SET-22/ftc-robot-code/animatronic-face/cad/exports/animatronic_face_assembly.step

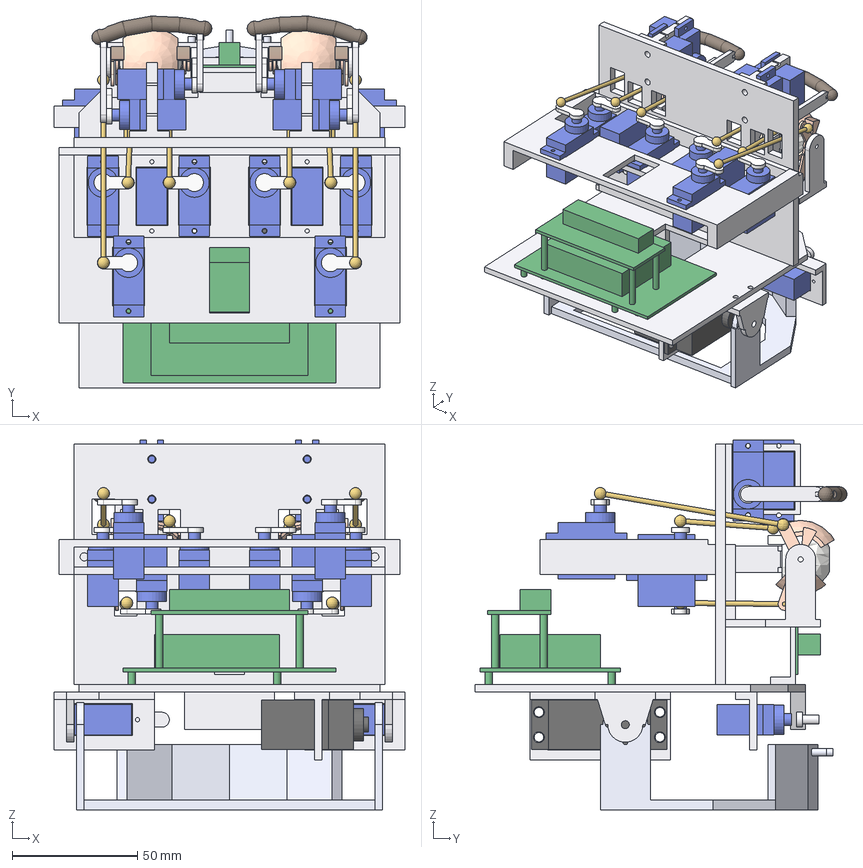
[picture p4: CAD file, 2026-11-02]
animatronic-face/cad/exports/animatronic_face_assembly.step
140.0 x 148.5 x 147.6 mm
eyeball_R
eye_cross_R
eye_frame_R
eyelid_upper_R
eyelid_lower_R
eyeball_L
eye_cross_L
eye_frame_L
eyelid_upper_L
eyelid_lower_L
face_plate
base_plate
eye_servo_cradle
servo_eyeA_R
servo_eyeA_R_horn
rod_eyeA_R
servo_eyeB_R
servo_eyeB_R_horn
rod_eyeB_R
servo_lidU_R
servo_lidU_R_horn
rod_lidU_R
servo_lidL_R
servo_lidL_R_horn
rod_lidL_R
servo_eyeA_L
servo_eyeA_L_horn
rod_eyeA_L
servo_eyeB_L
servo_eyeB_L_horn
rod_eyeB_L
servo_lidU_L
servo_lidU_L_horn
rod_lidU_L
servo_lidL_L
servo_lidL_L_horn
rod_lidL_L
servo_browIn_R
servo_browIn_R_horn
brow_lever_in_R
servo_browOut_R
servo_browOut_R_horn
brow_lever_out_R
servo_browIn_L
servo_browIn_L_horn
brow_lever_in_L
servo_browOut_L
servo_browOut_L_horn
brow_lever_out_L
brow_bracket_R
brow_strip_R
brow_bracket_L
brow_strip_L
servo_jaw
jaw
jaw_servo_bracket
jaw_hinge_bracket_R
jaw_hinge_bracket_L
servo_corner_R
mouth_corner_lever_R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
