SET-22/ftc-robot-code/animatronic-face/cad/exports/step/face_plate.step

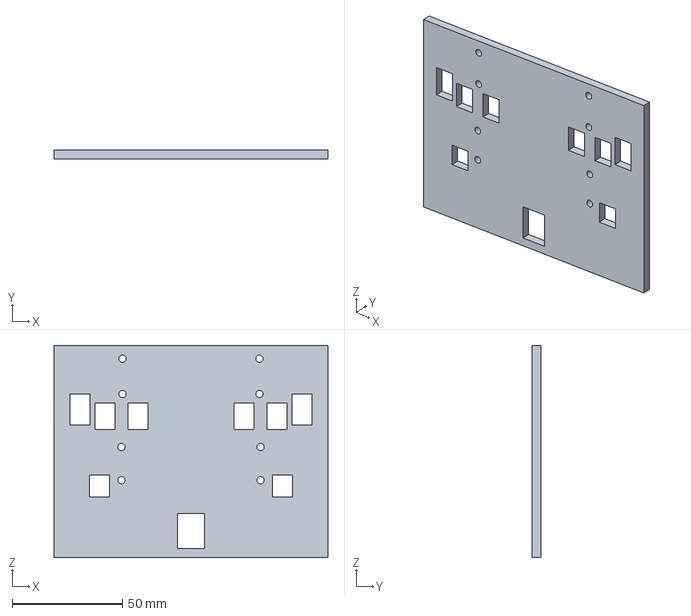
[picture p5: CAD file, 2026-11-02]
animatronic-face/cad/exports/step/face_plate.step
124.0 x 4.00 x 96.0 mm
