SET-22/ftc-robot-code/animatronic-face/cad/exports/step/eyelid_upper.step

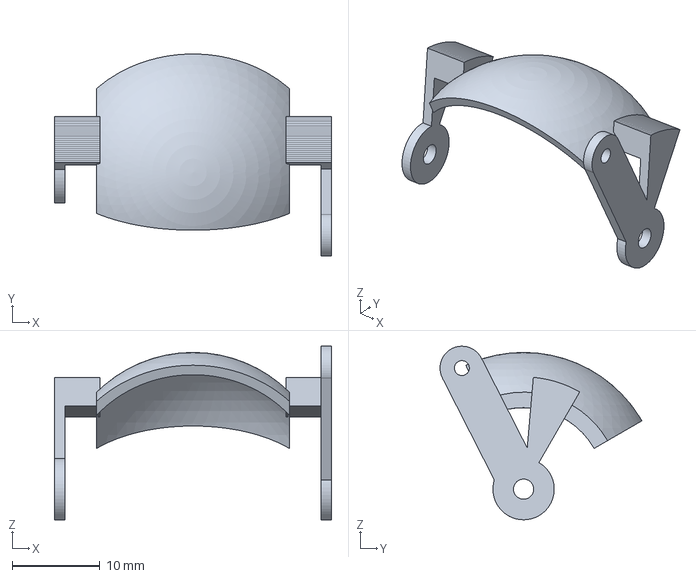
[picture p6: CAD file, 2026-11-02]
animatronic-face/cad/exports/step/eyelid_upper.step
31.6 x 23.0 x 19.8 mm
