SET-22/ftc-robot-code/animatronic-face/cad/exports/step/mouth_corner_lever.step

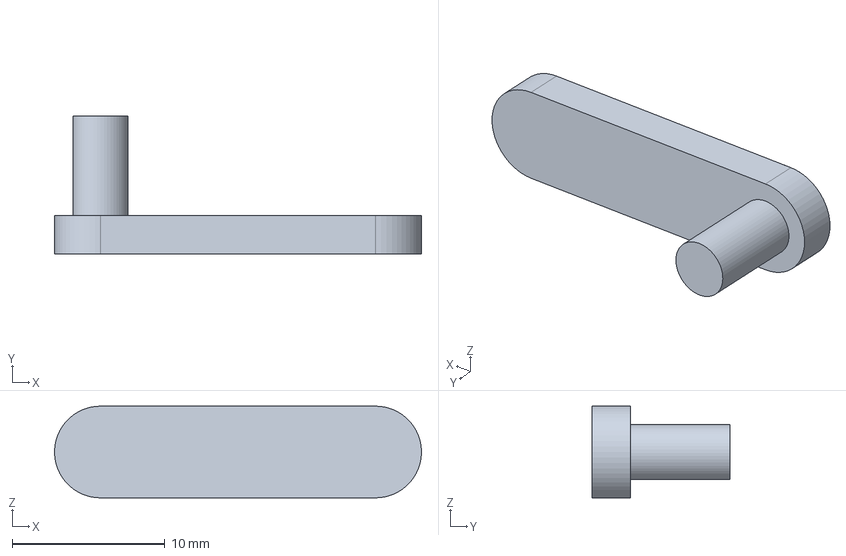
[picture p7: CAD file, 2026-11-02]
animatronic-face/cad/exports/step/mouth_corner_lever.step
24.0 x 9.00 x 6.00 mm
