SET-22/ftc-robot-code/animatronic-face/cad/exports/step/jaw_hinge_bracket.step

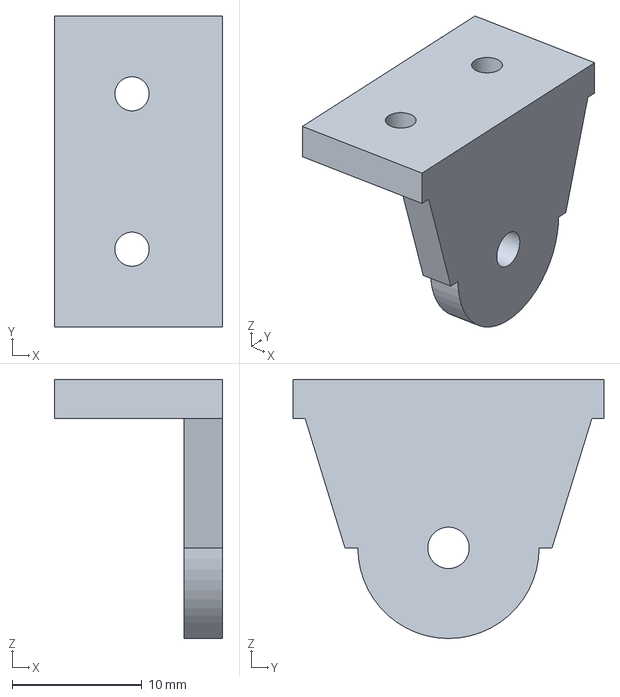
[picture p8: CAD file, 2026-11-02]
animatronic-face/cad/exports/step/jaw_hinge_bracket.step
13.0 x 24.0 x 20.0 mm
