SET-22/ftc-robot-code/animatronic-face/cad/exports/step/eye_servo_cradle.step

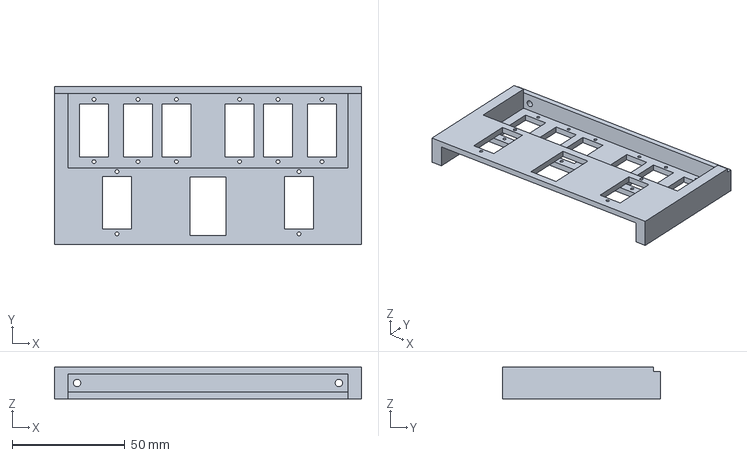
[picture p9: CAD file, 2026-11-02]
animatronic-face/cad/exports/step/eye_servo_cradle.step
136.0 x 70.0 x 14.0 mm
