SET-22/ftc-robot-code/animatronic-face/cad/exports/step/brow_lever_out.step

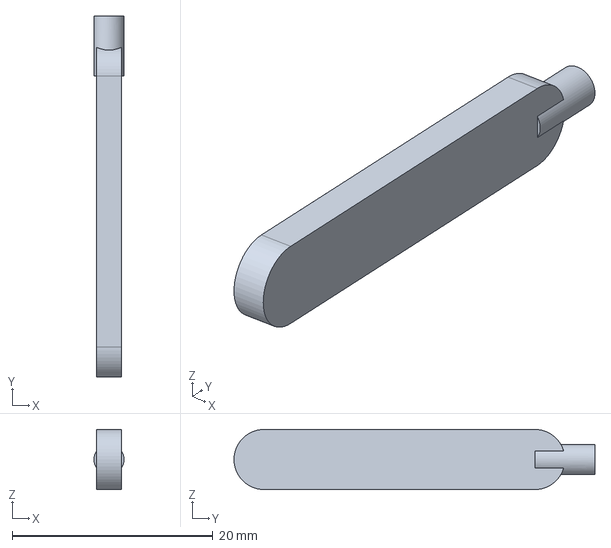
[picture p10: CAD file, 2026-11-02]
animatronic-face/cad/exports/step/brow_lever_out.step
3.00 x 36.0 x 6.00 mm
