SET-22/ftc-robot-code/animatronic-face/cad/exports/step/jaw_servo_bracket.step

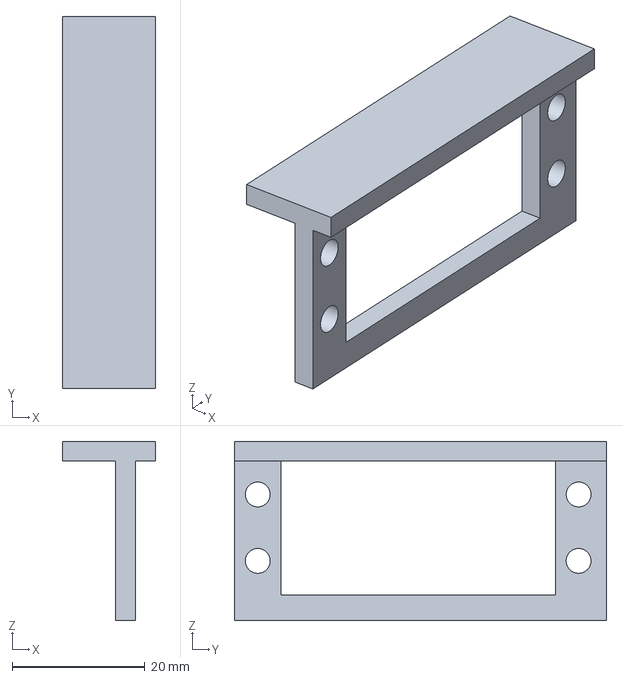
[picture p11: CAD file, 2026-11-02]
animatronic-face/cad/exports/step/jaw_servo_bracket.step
14.0 x 56.0 x 27.0 mm
