SET-22/ftc-robot-code/animatronic-face/cad/exports/step/eyelid_lower.step

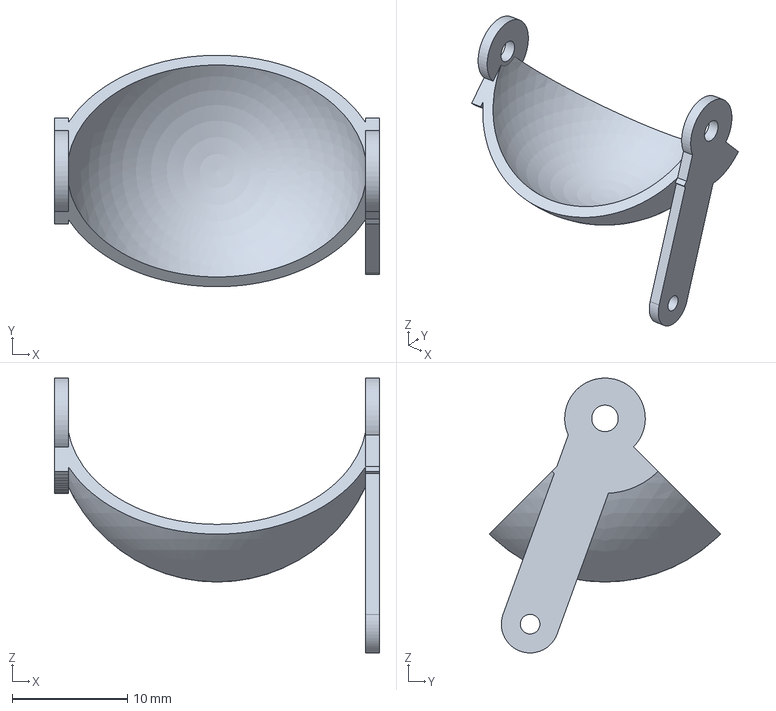
[picture p12: CAD file, 2026-11-02]
animatronic-face/cad/exports/step/eyelid_lower.step
28.2 x 20.1 x 23.9 mm
