SET-22/ftc-robot-code/animatronic-face/cad/exports/step/cheek_bracket.step

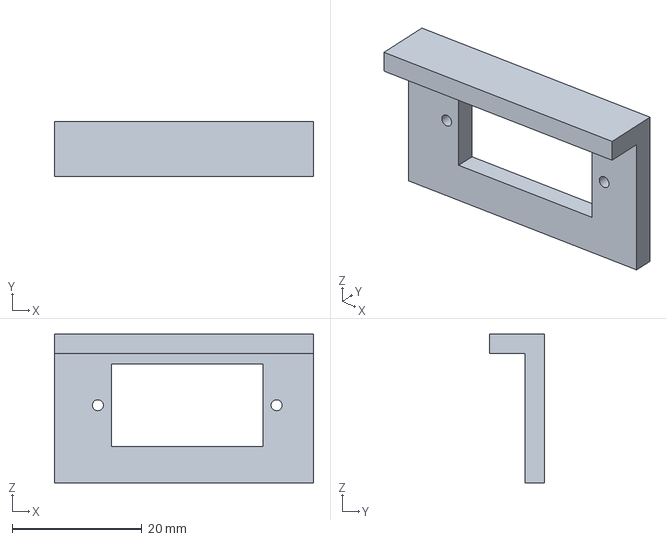
[picture p13: CAD file, 2026-11-02]
animatronic-face/cad/exports/step/cheek_bracket.step
40.0 x 8.50 x 23.0 mm
