SET-22/ftc-robot-code/animatronic-face/cad/exports/step/base_plate.step

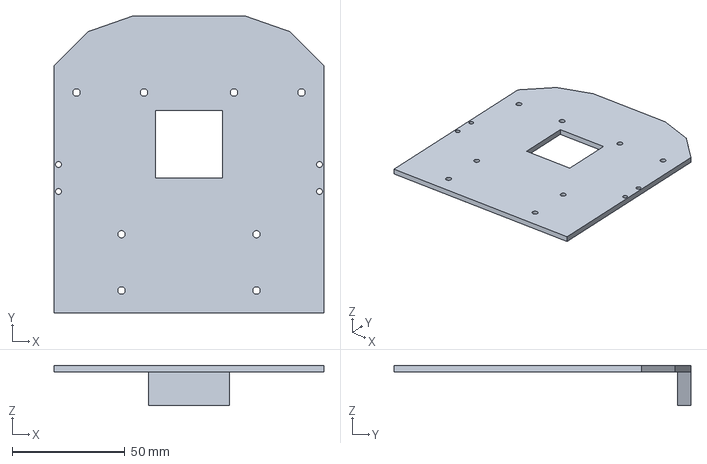
[picture p14: CAD file, 2026-11-02]
animatronic-face/cad/exports/step/base_plate.step
120.0 x 132.0 x 18.0 mm
