SET-22/ftc-robot-code/animatronic-face/cad/exports/step/eye_cross.step

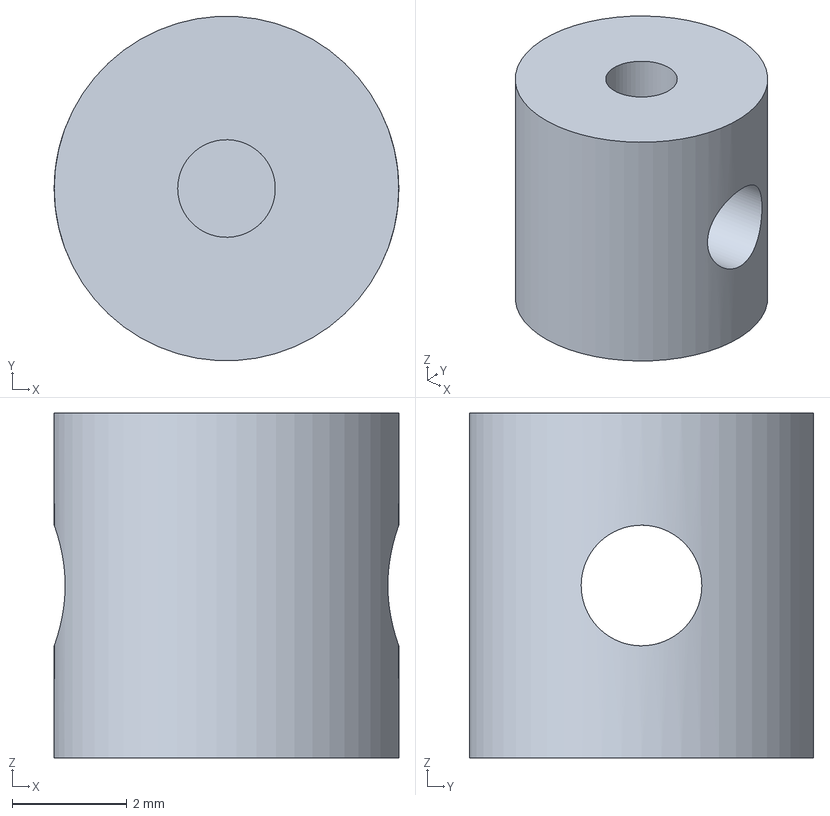
[picture p15: CAD file, 2026-11-02]
animatronic-face/cad/exports/step/eye_cross.step
6.00 x 5.99 x 6.00 mm
