SET-22/ftc-robot-code/animatronic-face/cad/exports/step/camera_mount.step

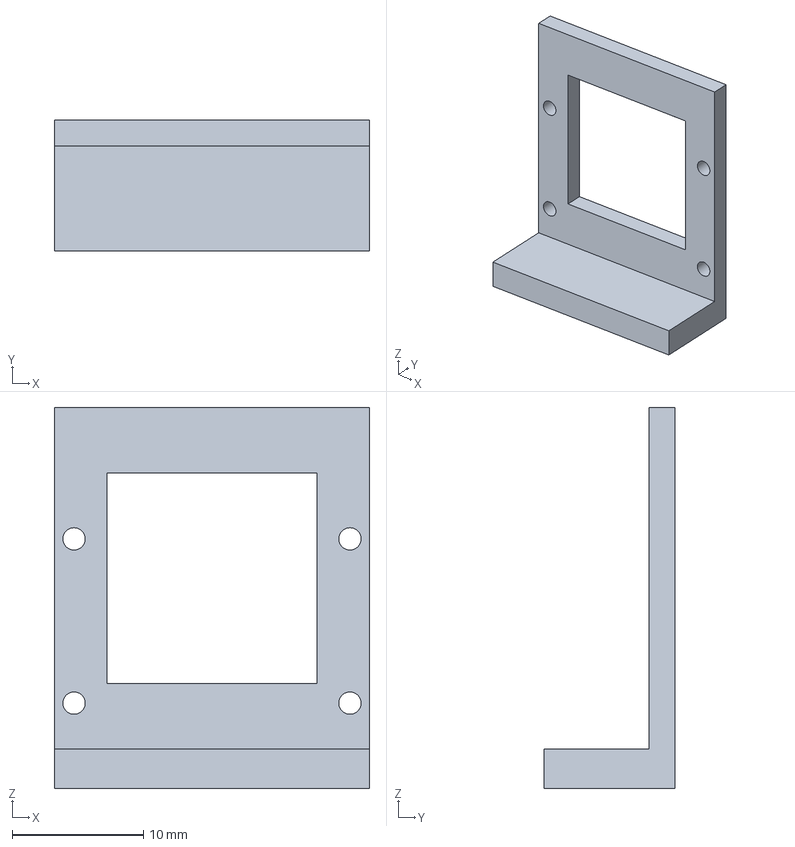
[picture p16: CAD file, 2026-11-02]
animatronic-face/cad/exports/step/camera_mount.step
24.0 x 10.0 x 29.0 mm
