SET-22/ftc-robot-code/animatronic-face/cad/exports/step/jaw.step

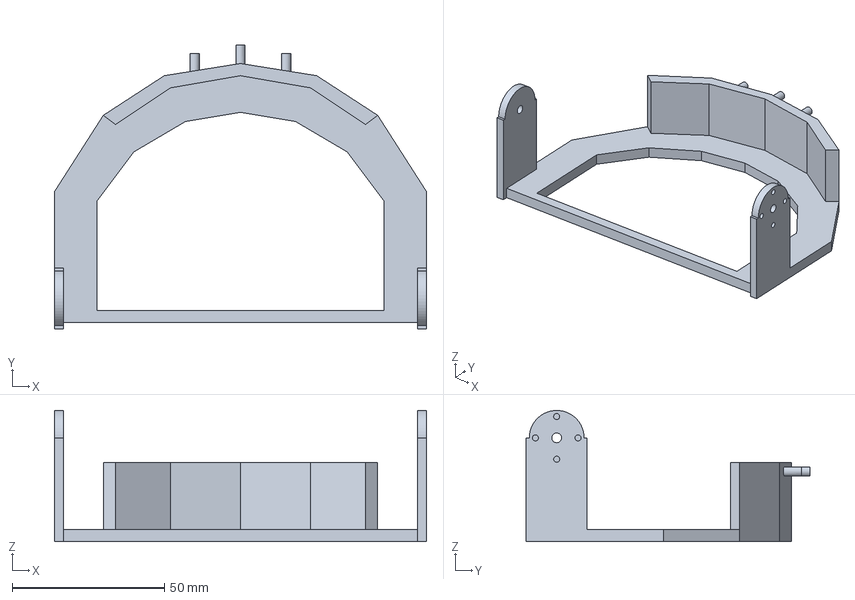
[picture p17: CAD file, 2026-11-02]
animatronic-face/cad/exports/step/jaw.step
122.0 x 93.0 x 43.0 mm
