SET-22/ftc-robot-code/animatronic-face/cad/exports/step/brow_strip.step

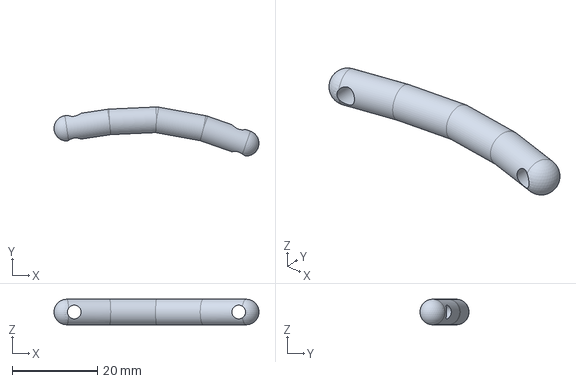
[picture p18: CAD file, 2026-11-02]
animatronic-face/cad/exports/step/brow_strip.step
48.0 x 11.5 x 6.00 mm
