SET-22/ftc-robot-code/animatronic-face/cad/exports/step/brow_bracket.step

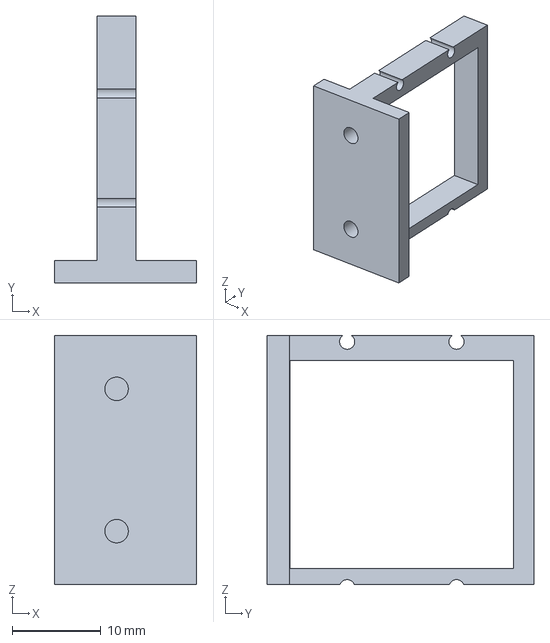
[picture p19: CAD file, 2026-11-02]
animatronic-face/cad/exports/step/brow_bracket.step
16.0 x 30.0 x 28.0 mm
