SET-22/ftc-robot-code/animatronic-face/cad/exports/step/eye_frame.step

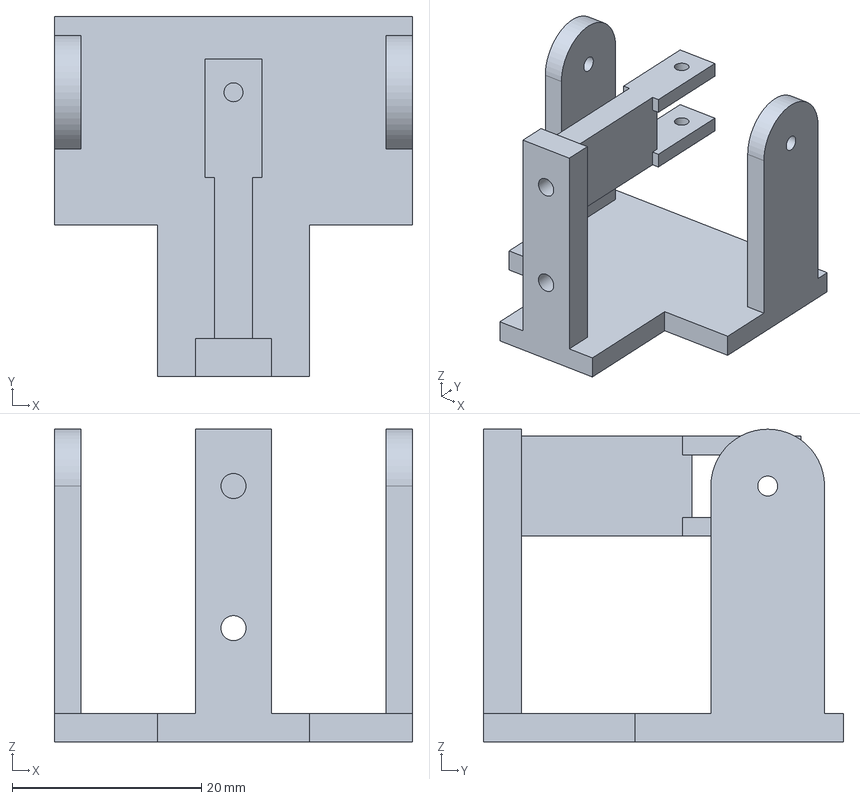
[picture p20: CAD file, 2026-11-02]
animatronic-face/cad/exports/step/eye_frame.step
37.8 x 38.0 x 33.0 mm
