SET-22/ftc-robot-code/animatronic-face/cad/exports/step/eyeball_rear_half.step

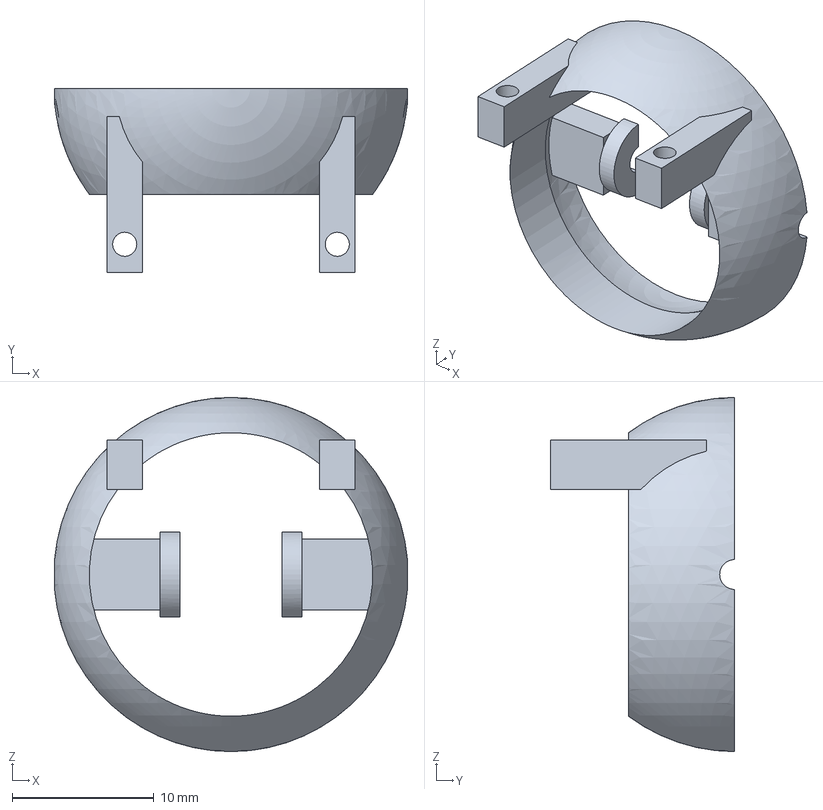
[picture p21: CAD file, 2026-11-02]
animatronic-face/cad/exports/step/eyeball_rear_half.step
24.9 x 13.0 x 25.0 mm
