SET-22/ftc-robot-code/animatronic-face/cad/exports/step/brow_lever_in.step

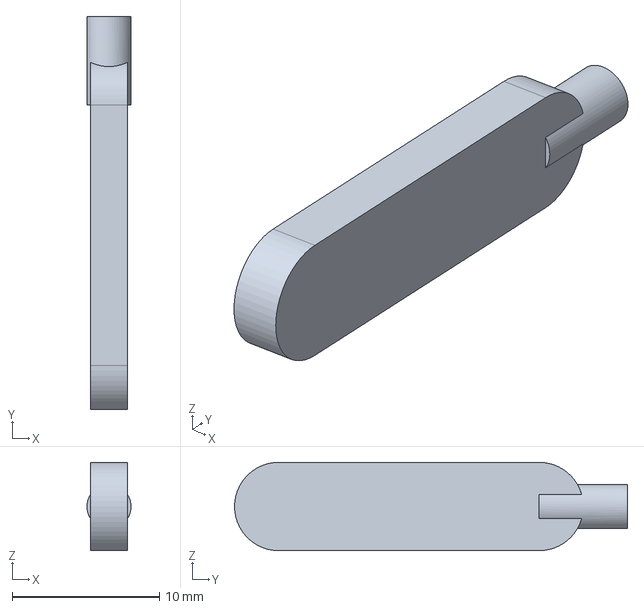
[picture p22: CAD file, 2026-11-02]
animatronic-face/cad/exports/step/brow_lever_in.step
3.00 x 26.7 x 6.00 mm
