SET-22/ftc-robot-code/animatronic-face/cad/exports/step/eyeball_front_half.step

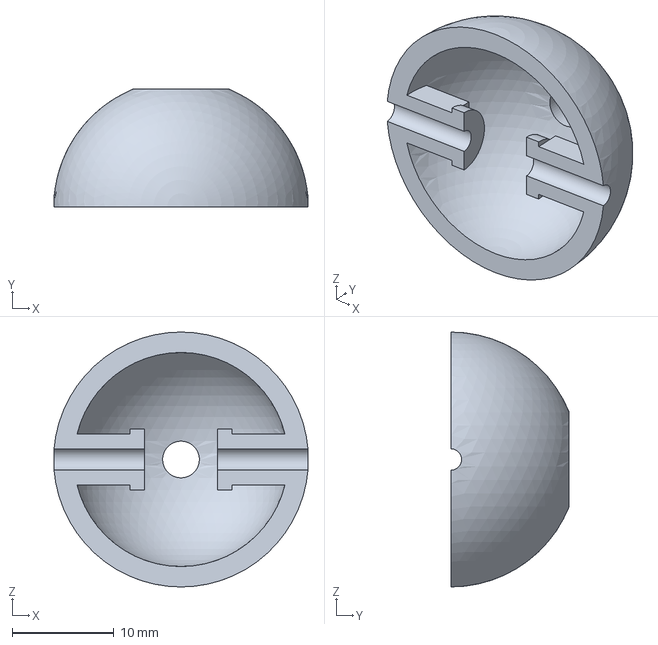
[picture p23: CAD file, 2026-11-02]
animatronic-face/cad/exports/step/eyeball_front_half.step
24.9 x 11.6 x 25.0 mm
