SET-22/ftc-robot-code/(list of files, cad)

Other CAD files:
animatronic-face/cad/exports/stl/base_plate.stl
animatronic-face/cad/exports/stl/brow_bracket.stl
animatronic-face/cad/exports/stl/brow_lever_in.stl
animatronic-face/cad/exports/stl/brow_lever_out.stl
animatronic-face/cad/exports/stl/brow_strip.stl
animatronic-face/cad/exports/stl/camera_mount.stl
animatronic-face/cad/exports/stl/cheek_bracket.stl
animatronic-face/cad/exports/stl/eye_cross.stl
animatronic-face/cad/exports/stl/eye_frame.stl
animatronic-face/cad/exports/stl/eye_servo_cradle.stl
animatronic-face/cad/exports/stl/eyeball_front_half.stl
animatronic-face/cad/exports/stl/eyeball_rear_half.stl
animatronic-face/cad/exports/stl/eyelid_lower.stl
animatronic-face/cad/exports/stl/eyelid_upper.stl
animatronic-face/cad/exports/stl/face_plate.stl
animatronic-face/cad/exports/stl/jaw.stl
animatronic-face/cad/exports/stl/jaw_hinge_bracket.stl
animatronic-face/cad/exports/stl/jaw_servo_bracket.stl
animatronic-face/cad/exports/stl/mouth_corner_lever.stl
