SET-22/ftc-robot-code/TeamCode/src/main/java/org/firstinspires/ftc/teamcode/pedro/Constants.java

package org.firstinspires.ftc.teamcode.pedro;

import com.pedropathing.algorithm.Foresight;
import com.pedropathing.algorithm.ForesightConfig;
import com.pedropathing.controllers.Controller;
import com.pedropathing.follower.Follower;
import com.pedropathing.math.Matrix;
import com.pedropathing.math.Vector2D;
import com.pedropathing.revhub.drivetrains.Mecanum;
import com.pedropathing.revhub.drivetrains.MecanumConfig;
import com.pedropathing.revhub.localizers.PinpointConfig;
import com.pedropathing.revhub.localizers.PinpointLocalizer;
import com.qualcomm.hardware.gobilda.GoBildaPinpointDriver;
import com.qualcomm.robotcore.hardware.DcMotorSimple;
import com.qualcomm.robotcore.hardware.HardwareMap;
import org.firstinspires.ftc.robotcore.external.navigation.DistanceUnit;

public class Constants {

    // ---------- Drivetrain ----------
    public static MecanumConfig drivetrainConfig = new MecanumConfig(c -> {
        c.frontLeftName.set("fl");
        c.frontRightName.set("fr");
        c.backLeftName.set("bl");
        c.backRightName.set("br");

        c.frontLeftDirection.set(DcMotorSimple.Direction.FORWARD);
        c.frontRightDirection.set(DcMotorSimple.Direction.REVERSE);
        c.backLeftDirection.set(DcMotorSimple.Direction.FORWARD);
        c.backRightDirection.set(DcMotorSimple.Direction.REVERSE);

        c.manualBrakeMode.set(true);
    });

    // ---------- Localizer: goBILDA Pinpoint (values from the Pinpoint AutoTune) ----------
    public static PinpointConfig localizerConfig = new PinpointConfig(c -> {
        c.name.set("pinpoint");
        c.podType.set(GoBildaPinpointDriver.GoBildaOdometryPods.goBILDA_4_BAR_POD);
        c.xPodOffset.set(0.8406837343230962);
        c.yPodOffset.set(-4.389433973417508);
        c.xPodDirection.set(GoBildaPinpointDriver.EncoderDirection.FORWARD);
        c.yPodDirection.set(GoBildaPinpointDriver.EncoderDirection.REVERSED);
        c.globalDistanceUnit.set(DistanceUnit.INCH);
        c.offsetUnits.set(DistanceUnit.INCH);
    });

    // ---------- Foresight (algorithm) ----------
    // These are the example values from Pedro's docs, NOT values for your robot.
    // Run the Foresight AutoTune (http://192.168.43.1:10158) and replace this block.
    public static ForesightConfig foresightConfig = new ForesightConfig(c -> {
        Controller primaryTranslationalForward = Controller.proportional(0.3);
        Controller secondaryTranslationalForward = Controller.proportional(0.1);
        Controller primaryTranslationalLateral = Controller.proportional(0.3);
        Controller secondaryTranslationalLateral = Controller.proportional(0.1);

        c.forwardTranslational.set(Controller.piecewise(secondaryTranslationalForward).put(2.5, primaryTranslationalForward));
        c.strafeTranslational.set(Controller.piecewise(secondaryTranslationalLateral).put(2.5, primaryTranslationalLateral));

        c.coast.set(Controller.proportionalFeedforward(0.010978350889324107));
        c.brake.set(Controller.proportionalFeedforward(0.008731598255925491));

        c.headingFeedback.set(Controller.proportional(5.258721785960744));
        c.headingBrakeCoefficients.set(Vector2D.cartesian(0.05642143125655298, 0.0063829525363003695));

        c.linearBrakeCoefficients.set(Matrix.diag(0.10605894992901523, 0.08719146175596092));
        c.quadraticBrakeCoefficients.set(Matrix.diag(0.0014663966976606565, 0.0013837064502458813));

        c.maxAchievableForwardVelocity.set(72.72923108818539);
        c.maxAchievableStrafeVelocity.set(52.34323936525474);
        c.naturalForwardDeceleration.set(85.01144677379789);
        c.naturalStrafeDeceleration.set(104.49787535782846);
    });

    public static Follower create(HardwareMap h) {
        return new Follower(
                new PinpointLocalizer(h, localizerConfig),
                new Mecanum(h, drivetrainConfig),
                new Foresight(foresightConfig)
        );
    }
}
