SET-22/ftc-robot-code/TeamCode/src/main/java/org/firstinspires/ftc/teamcode/pedro/Tuning.java

package org.firstinspires.ftc.teamcode.pedro;

import com.pedropathing.revhub.drivetrains.Mecanum;
import com.pedropathing.revhub.localizers.PinpointLocalizer;
import com.pedropathing.tuning.autotune.Procedure;
import com.pedropathing.tuning.autotune.Tuner;

import org.firstinspires.ftc.teamcode.pedro.procedures.ForesightTuner;
import org.firstinspires.ftc.teamcode.pedro.procedures.MecanumTuner;
import org.firstinspires.ftc.teamcode.pedro.procedures.PinpointTuner;
import org.firstinspires.ftc.teamcode.pedro.procedures.Tests;

public class Tuning {
    // Tuners go here
    @Tuner
    public static Procedure mecanumTuner() {
        return new MecanumTuner();
    }

    @Tuner
    public static Procedure pinpointTuner() {
        return new PinpointTuner();
    }

    @Tuner
    public static Procedure tests() {
        return new Tests(
                hardwareMap -> new Mecanum(hardwareMap, Constants.drivetrainConfig),
                hardwareMap -> new PinpointLocalizer(hardwareMap, Constants.localizerConfig),
                null
        );
    }
    @Tuner
    public static Procedure foresightTuner() {
        return new ForesightTuner((hardwareMap) -> new PinpointLocalizer(hardwareMap, Constants.localizerConfig), (hardwareMap) -> new Mecanum(hardwareMap, Constants.drivetrainConfig));
    }
}
