SET-22/ftc-robot-code/(commit log)

2026-10-23 Added transfer, shooter, and servo
2026-11-02 Add life-size animatronic face v0.1 CAD, parts list and research notes
    Parametric CadQuery model of an expressive robot face (15 servos):
    differential pan/tilt eyes on centre U-joints, independent upper/lower
    eyelids, two-point TPU eyebrows, direct-drive jaw and mouth corners,
    Pi 5 + PCA9685 + nose-bridge camera. Exports an Onshape-importable STEP
    assembly, per-part STEP/STL files and preview renders; includes an
    interference check across 7 expression poses, BOM and FACS-based notes.
    Claude-Session: https://claude.ai/code/session_01R7QydbfAYY34VuJhyLVmDB
